galaxy31122004-arch/Do-an-Tuan/documents/sources/esp32-c3-supermini/pinout.png

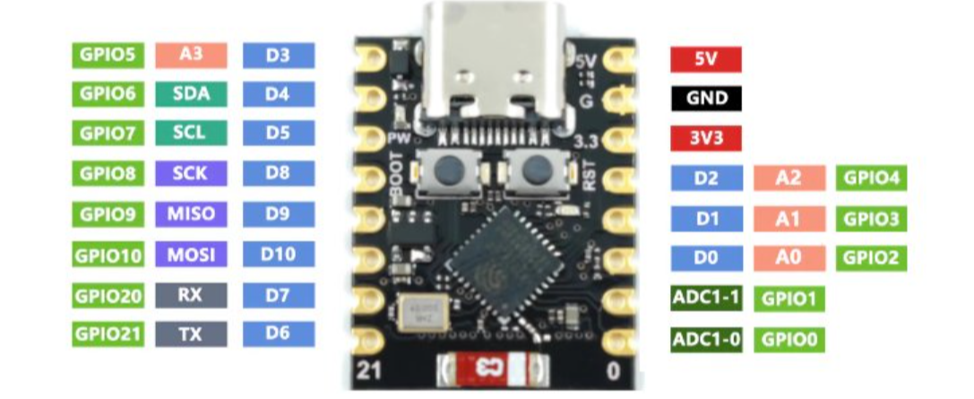
documents/sources/esp32-c3-supermini/pinout.png
