galaxy31122004-arch/Do-an-Tuan/documents/bao-cao-do-an-2/figures/pcb-top.png

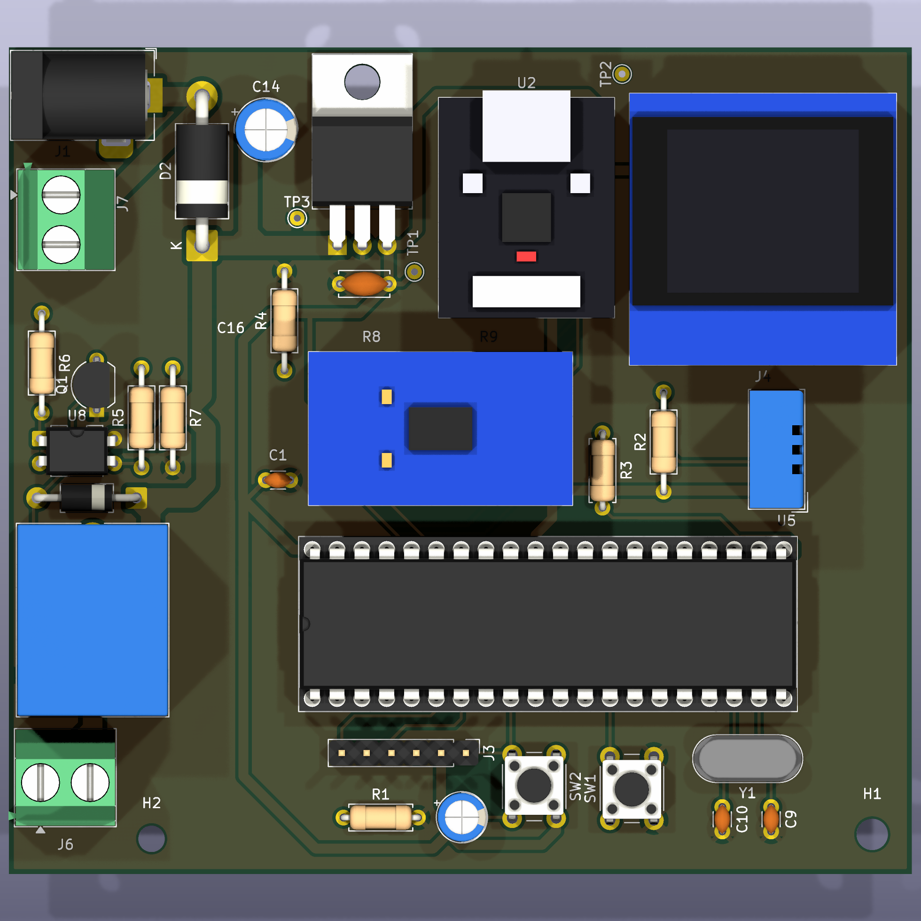
documents/bao-cao-do-an-2/figures/pcb-top.png
