galaxy31122004-arch/Do-an-Tuan/.agents/skills/README.md

# Workspace-local skills

- [workspace-guide](workspace-guide/SKILL.md): workspace conventions and entrypoints for Codex and Claude.

Reusable personal skills belong in a separate collection outside this project (D:\Personal-Skills on the current machine), separate from AXON. Do not copy that collection or plugin caches into the workspace.
