galaxy31122004-arch/Do-an-Tuan/documents/bao-cao-do-an-2/02-yeu-cau-thong-tin.md

# Yêu cầu thông tin và độ sâu — Báo cáo Đồ án 2

Mức viết: `khái quát` · `vừa đủ` · `chuyên sâu` · `tùy chỉnh`. Mức đề xuất ghi trong ngoặc, chờ người dùng chốt.

| Phần | Mức (đề xuất) | Dữ liệu đã có | Còn thiếu | Trạng thái |
|---|---|---|---|---|
| Mở đầu | vừa đủ | Bản tóm tắt đề tài | — | chờ duyệt |
| Chương 1 | vừa đủ | Datasheet công khai, docs/sources.md | Có giới hạn trang cho chương lý thuyết không | chờ duyệt |
| Chương 2 | chuyên sâu | KiCad, BOM, wiring.md, net class | Kích thước header ESP32/TXS chưa đo; giá một số linh kiện chưa khảo sát | đã giao v1.0.0 |
| Chương 3 | chuyên sâu | firmware v0.2.0, dashboard/generate.py | Ảnh dashboard chạy thật (nếu có) | chờ duyệt |
| Chương 4 | vừa đủ | Kế hoạch kiểm thử, kiểm thử phần mềm (checksum HEX, artifact) | **Ảnh mạch thật, số đo nhiệt độ/độ ẩm, kết quả gửi cloud** — chưa có, không tự tạo | chờ dữ liệu |
| Kết luận | khái quát | — | Phụ thuộc chương 4 | chờ |

## Đã chốt (2026-11-08)
- MSSV, địa danh/năm trên bìa: để trống, người dùng tự điền.
- Bìa ghi "BÁO CÁO ĐỒ ÁN 2"; bìa không ảnh (khung, logo, chữ).
- Khoa không quy định thêm; dùng định dạng mặc định trong tệp 01.
- Đồng ý mức viết từng chương như bảng.
- Mạch thật chưa làm/đo: chương 4 viết dạng kế hoạch kiểm thử, kết quả bổ sung sau.
- Không có lời cảm ơn.
- 2026-11-08: cập nhật theo PCB bản cuối (I²C P0.3/P0.4 + R8/R9, UART qua TXS B1/B2, ESP32 RX=GPIO3/TX=GPIO4, bo 92,5 × 84,7 mm đã đi dây, GND phủ hai mặt, bỏ LED D1/R10); hình 2.2, 2.3 và lưu đồ ESP32 dựng lại.
- 2026-11-09: sơ đồ nguyên lý vẽ lại theo 9 khối; PCB đi dây chỉ góc 45°, R1/R3 nằm sát bo; người dùng duyệt, giao `versions/documents/bao-cao-do-an-2/v1.0.0/` (41 trang).
- Dàn ý tệp 01 đã duyệt. Tiến độ: Mở đầu, Chương 1, 2 đã duyệt; Chương 3, 4, Kết luận, TLTK, Phụ lục viết theo yêu cầu "viết hết" và dựng Word `drafts/bao-cao-do-an-2.docx`, chờ duyệt.

## Câu hỏi ưu tiên (đã trả lời)
1. Mã số sinh viên của hai bạn; năm và địa danh ghi trên bìa (ví dụ "Bình Định, 2026"?).
2. Loại tài liệu ghi trên bìa: "BÁO CÁO ĐỒ ÁN 2" hay tên khác theo khoa?
3. Khoa có quy định số trang, cỡ chữ, lề hay cách trích dẫn (IEEE/APA) không?
4. Mức viết từng chương như bảng trên có đồng ý không?
5. Chương 4: mạch thật đã làm/đo chưa? Nếu chưa, viết chương 4 dạng kế hoạch kiểm thử và để kết quả bổ sung sau.
6. Bìa không ảnh (chỉ khung, logo, chữ) có được không?
7. Có cần lời cảm ơn, nhận xét GVHD không?

## Ghi chú
- Không suy diễn kết quả đo hay độ chính xác chưa kiểm chứng.
- Thiết kế đã thay đổi so với bản tóm tắt: thêm relay (PC817 + C1815, bật ≥ 32 °C, tắt ≤ 30 °C), nguồn 12 V qua LM7805, OE = GPIO0, TX ESP32 = GPIO3.
