galaxy31122004-arch/Do-an-Tuan/documents/sources/de-tai/TÓM TẮT ĐỀ TÀI ĐỒ ÁN 2 - IoT OLED.docx

TÓM TẮT ĐỀ TÀI ĐỒ ÁN

THIẾT KẾ HỆ THỐNG GIÁM SÁT NHIỆT ĐỘ, ĐỘ ẨM SỬ DỤNG AT89S52, ESP32-C3 VÀ NỀN TẢNG IoT

Sinh viên thực hiện: Phạm Thanh Tuấn, Nguyễn Quốc Sinh.

Lớp: Kỹ thuật điện tử - viễn thông K46.

Giảng viên hướng dẫn: TS Nguyễn Đỗ Dũng.

1. Lý do chọn đề tài

Nhiệt độ và độ ẩm tương đối là những thông số cần theo dõi trong sinh hoạt, bảo quản sản phẩm và các mô hình giám sát môi trường. Hệ thống chỉ hiển thị tại chỗ giúp người sử dụng quan sát tức thời nhưng chưa hỗ trợ theo dõi từ xa và xem lại diễn biến theo thời gian.

Đề tài hướng đến thiết kế mạch thật vừa đo và hiển thị tại chỗ, vừa truyền dữ liệu qua Internet để lưu trữ, xem biểu đồ và cảnh báo vượt ngưỡng. AT89S52 đảm nhiệm thu thập và hiển thị; ESP32-C3 phụ trách kết nối mạng. Nền tảng IoT có sẵn, theo hướng ThingsBoard, được sử dụng để xây dựng dashboard giám sát trên trình duyệt.

2. Mục tiêu của đề tài

- Tìm hiểu và lập trình AT89S52 để đọc nhiệt độ, độ ẩm từ DHT11; ESP32-C3 đồng bộ giờ NTP, gắn thời gian UTC cho bản ghi và gửi giờ về AT89S52 để hiển thị.

- Thay LCD 2004 bằng OLED trắng 0,96 inch, giao tiếp I²C dùng SSD1315 theo module đã chọn. Xây dựng hai trang thông tin và nút nhấn chuyển trang: trang số đo/ngày giờ; trang trạng thái Wi-Fi, cloud và lần gửi thành công gần nhất.

- Thiết kế giao tiếp UART giữa AT89S52 và ESP32-C3. AT89S52 gửi bản ghi đo; ESP32-C3 phản hồi trạng thái kết nối và gửi dữ liệu để AT89S52 cập nhật màn hình.

- Lập trình ESP32-C3 kết nối Wi-Fi, truyền dữ liệu lên nền tảng IoT và tự kết nối lại khi mất mạng. Lựa chọn, cấu hình nền tảng theo hướng ThingsBoard và các chức năng cần triển khai.

- Thiết lập lưu trữ các bản ghi gồm mã thiết bị, thời gian đo, nhiệt độ và độ ẩm. Cấu hình dashboard web hiển thị dữ liệu mới nhất, biểu đồ lịch sử, lọc theo khoảng thời gian và xuất dữ liệu CSV.

- Cấu hình ngưỡng nhiệt độ, độ ẩm trên nền tảng/web; hiển thị và lưu lịch sử cảnh báo vượt ngưỡng. Phạm vi ban đầu gồm một thiết bị và một tài khoản chủ thiết bị để xem dữ liệu, chỉnh ngưỡng.

- Chế tạo, kiểm tra mạch thật và đánh giá toàn bộ luồng đo, hiển thị, truyền dữ liệu, lưu trữ và giám sát từ xa. Mô phỏng các khối phù hợp trên Proteus để hỗ trợ kiểm tra trước khi tích hợp.

3. Sơ đồ khối

DHT11 → AT89S52
NTP qua Internet → ESP32-C3 → Giờ UTC gửi về AT89S52
AT89S52 → OLED SSD1315 (I²C)
Nút chuyển trang → AT89S52
AT89S52 ↔ ESP32-C3 (UART)
ESP32-C3 → Wi-Fi/Internet → Nền tảng IoT → Dashboard web

Nguồn cấp được phân phối phù hợp cho từng khối. Module TXS0108E chuyển mức I²C và UART giữa phía AT89S52 5 V và OLED/ESP32-C3 3,3 V; chân OE được ESP32-C3 điều khiển sau khi nguồn ổn định. AT89S52 phụ trách đo và hiển thị; ESP32-C3 phụ trách mạng; nền tảng IoT phụ trách lưu trữ, dashboard và xử lý cảnh báo.

4. Nguyên lý hoạt động

Sau khi cấp nguồn, AT89S52 khởi tạo cảm biến và màn hình; ESP32-C3 kết nối mạng và đồng bộ giờ NTP. AT89S52 đọc DHT11, kiểm tra dữ liệu và cập nhật số đo lên OLED. ESP32-C3 gửi giờ UTC cho AT89S52 để hiển thị UTC+7. Khi chưa đồng bộ hoặc mất cập nhật thời gian từ ESP32-C3, OLED báo chưa đồng bộ giờ. Nút nhấn cho phép chuyển giữa trang đo và trang kết nối. Cách điều khiển OLED được lựa chọn phù hợp với bộ nhớ AT89S52 và kiểm tra trên module thực tế.

AT89S52 gửi bản ghi đo sang ESP32-C3 qua UART. ESP32-C3 gắn thời gian UTC lúc nhận bản ghi, bổ sung thông tin nhận diện thiết bị khi cần và chuyển dữ liệu qua Wi-Fi/Internet lên nền tảng ThingsBoard. Trạng thái kết nối và lần gửi thành công được gửi về AT89S52 để hiển thị tại chỗ.

Nền tảng lưu dữ liệu theo thời gian và cung cấp dashboard cho người sử dụng truy cập bằng tài khoản chủ thiết bị. Dashboard hiển thị số đo mới nhất cùng thời gian cập nhật, biểu đồ lịch sử, bộ lọc thời gian và chức năng xuất CSV. Ngưỡng cảnh báo được cấu hình trên nền tảng; khi số đo vượt ngưỡng, hệ thống đánh dấu và lưu sự kiện cảnh báo để tra cứu.

Khi mất Internet, AT89S52 vẫn đo và hiển thị tại chỗ; ESP32-C3 thực hiện kết nối lại và duy trì giờ đã đồng bộ trong khi còn nguồn. Sau mất điện, hệ thống cần NTP để đồng bộ lại; không sử dụng RTC ngoài hoặc pin dự phòng. Dashboard thể hiện thời điểm dữ liệu cuối và trạng thái mất kết nối để phân biệt dữ liệu cũ với số đo hiện tại. Phiên bản đầu không lưu bù dữ liệu trong thời gian mất mạng; lịch sử cần thể hiện khoảng thiếu dữ liệu.

Khi cảm biến lỗi hoặc bản ghi không hợp lệ, hệ thống báo trạng thái lỗi và không coi dữ liệu đó là số đo hợp lệ. Sau khi kết nối được khôi phục, hệ thống tiếp tục gửi các bản ghi mới. Cảnh báo vượt ngưỡng thuộc phạm vi nền tảng/web; đề tài chưa đặt yêu cầu điều khiển tải hoặc bổ sung còi cảnh báo.

5. Mô phỏng và kiểm tra

- Nạp và kiểm tra file HEX AT89S52 bằng mạch nạp Burn-E, sau đó lắp AT89S52 vào mạch. Thiết kế sơ đồ mạch, kiểm tra nguồn và mức tín hiệu giữa các khối; mô phỏng phần đo và hiển thị trên Proteus khi có mô hình phù hợp. Kiểm thử Wi-Fi và cloud bằng mạch thật.

- Kiểm tra đọc DHT11, đồng bộ NTP và truyền giờ về AT89S52, hiển thị hai trang OLED và thao tác nút nhấn. Đối chiếu số đo với thiết bị tham chiếu nếu có, ghi nhận sai lệch quan sát được.

- Kiểm tra trao đổi UART và tính nhất quán của nhiệt độ, độ ẩm, thời gian giữa AT89S52, ESP32-C3 và dữ liệu lưu trên nền tảng.

- Kiểm tra truy cập dashboard qua Internet, dữ liệu mới nhất, biểu đồ, lọc lịch sử, xuất CSV, cấu hình ngưỡng và lưu lịch sử cảnh báo.

- Thử các tình huống cảm biến lỗi, bản ghi lỗi, vượt ngưỡng, mất Wi-Fi/Internet, kết nối lại và khởi động lại thiết bị. Xác nhận việc mất mạng không làm gián đoạn đo và hiển thị tại chỗ.

- Tổng hợp kết quả thực nghiệm, đánh giá tính ổn định, khả năng cập nhật dữ liệu và các giới hạn của mô hình; đề xuất lưu bù dữ liệu và mở rộng nhiều thiết bị cho giai đoạn sau.
