galaxy31122004-arch/Do-an-Tuan/documents/sources/de-tai/README.md

# Tóm tắt đề tài — tư liệu gốc

- Nguồn: người dùng cung cấp; trước đây nằm ở thư mục gốc repo, chuyển vào đây ngày 08/11/2026 khi áp cấu trúc workspace.
- [TÓM TẮT ĐỀ TÀI ĐỒ ÁN 2.docx](TÓM%20TẮT%20ĐỀ%20TÀI%20ĐỒ%20ÁN%202.docx): bản tóm tắt đề tài gốc.
- [TÓM TẮT ĐỀ TÀI ĐỒ ÁN 2 - IoT OLED.docx](TÓM%20TẮT%20ĐỀ%20TÀI%20ĐỒ%20ÁN%202%20-%20IoT%20OLED.docx): bản cập nhật theo hướng IoT + OLED.
- Phạm vi đã xác nhận nằm ở [02-yeu-cau-thong-tin.md](../../de-tai/02-yeu-cau-thong-tin.md); nội dung hai file chưa được đọc lại trong lần chuyển này.
