galaxy31122004-arch/Do-an-Tuan/documents/sources/de-tai/TÓM TẮT ĐỀ TÀI ĐỒ ÁN 2.docx

TÓM TẮT ĐỀ TÀI ĐỒ ÁN

THIẾT KẾ MẠCH CẢM BIẾN ĐỘ ẨM TƯƠNG ĐỐI VÀ NHIỆT ĐỘ SỬ DỤNG PIC16F877A, MÀN HÌNH LCD 2004, RTC DS1307 và DHT11.

Sinh viên thực hiện : Phạm Thanh Tuấn,

Nguyễn Quốc Sinh .

Lớp : Kỹ thuật điện tử - viễn thông k46

Giảng viên hướng dẫn: TS Nguyễn Đỗ Dũng.

1. Lý do chọn đề tài

Trong đời sống hằng ngày cũng như trong sản xuất, nhiệt độ và độ ẩm tương đối là hai thông số môi trường có ảnh hưởng đáng kể đến sức khỏe con người, quá trình bảo quản sản phẩm và hoạt động của nhiều thiết bị. Việc theo dõi chính xác các thông số này giúp con người nắm bắt được tình trạng môi trường và có những biện pháp điều chỉnh phù hợp khi cần thiết.

Cùng với sự phát triển của khoa học kỹ thuật, các hệ thống đo lường và giám sát nhiệt độ, độ ẩm ngày càng được ứng dụng rộng rãi trong gia đình, nông nghiệp, nhà kính, kho bảo quản và các hệ thống tự động hóa. Vì vậy, việc nghiên cứu và thiết kế một mạch có khả năng đo nhiệt độ, độ ẩm và hiển thị các thông số một cách trực quan có ý nghĩa thực tiễn. Đó là lý do em chọn đề tài này .

2. Mục tiêu của đề tài

Tìm hiểu cấu tạo, nguyên lý hoạt động và cách sử dụng vi điều khiển PIC16F877A.

Tìm hiểu cảm biến DHT11 và phương pháp thu thập dữ liệu nhiệt độ, độ ẩm tương đối.

Thiết kế mạch giao tiếp giữa DHT11 và PIC16F877A.

Tìm hiểu và sử dụng RTC DS1307 để đo và duy trì thời gian thực.

Thiết kế giao tiếp giữa PIC16F877A với LCD 2004 để hiển thị các thông số.

Lập trình PIC16F877A để đọc dữ liệu từ DHT11 và DS1307, xử lý dữ liệu và hiển thị lên LCD.

Mô phỏng và kiểm tra hoạt động của hệ thống trên Proteus.

Đánh giá kết quả hoạt động và đề xuất hướng phát triển của hệ thống.

3 . Sơ đồ khối

PIC

DS 1307

Cảm biến

DHT11

LCD

NGUỒN

4 . Nguyên lý hoạt động

Sau khi được cấp nguồn, toàn bộ hệ thống bắt đầu hoạt động. Vi điều khiển PIC16F877A đóng vai trò là bộ điều khiển trung tâm, thực hiện khởi tạo các thiết bị ngoại vi và điều khiển quá trình thu thập, xử lý và hiển thị dữ liệu.

Đầu tiên, PIC16F877A gửi tín hiệu yêu cầu đến cảm biến DHT11 để thực hiện phép đo. DHT11 tiến hành đo nhiệt độ và độ ẩm tương đối của môi trường, sau đó truyền dữ liệu số về PIC16F877A thông qua đường truyền dữ liệu. Vi điều khiển tiếp nhận và xử lý dữ liệu để xác định giá trị nhiệt độ theo đơn vị °C và độ ẩm tương đối theo đơn vị %RH.

Đồng thời, PIC16F877A giao tiếp với mạch thời gian thực DS1307 thông qua chuẩn giao tiếp I²C để đọc các thông tin về giây, phút, giờ, ngày, tháng và năm. DS1307 có nguồn pin dự phòng giúp duy trì thông tin thời gian khi nguồn chính của hệ thống bị ngắt.

Sau khi thu thập dữ liệu từ DHT11 và DS1307, PIC16F877A tiến hành xử lý và gửi các kết quả đến màn hình LCD 2004. LCD hiển thị các thông số nhiệt độ, độ ẩm tương đối và thời gian thực để người sử dụng có thể theo dõi trực tiếp.

Quá trình đo, xử lý và hiển thị được thực hiện lặp lại liên tục theo chương trình đã lập trình trong PIC16F877A. Khi nhiệt độ hoặc độ ẩm môi trường thay đổi, giá trị hiển thị trên LCD cũng được cập nhật tương ứng. Nhờ đó, hệ thống có khả năng giám sát các thông số nhiệt độ, độ ẩm và thời gian thực của môi trường một cách trực quan và liên tục.

5 . Mô phỏng và kiểm tra

Thiết kế mạch trên Proteus

Nạp chương trình cho PIC16F877A

Kiểm tra khả năng đọc dữ liệu DHT11

Kiểm tra thời gian từ DS1307

Kiểm tra khả năng hiển thị trên LCD 2004

Đánh giá kết quả và những hạn chế của mô hình .
