galaxy31122004-arch/Do-an-Tuan/dashboard/local/preview.png

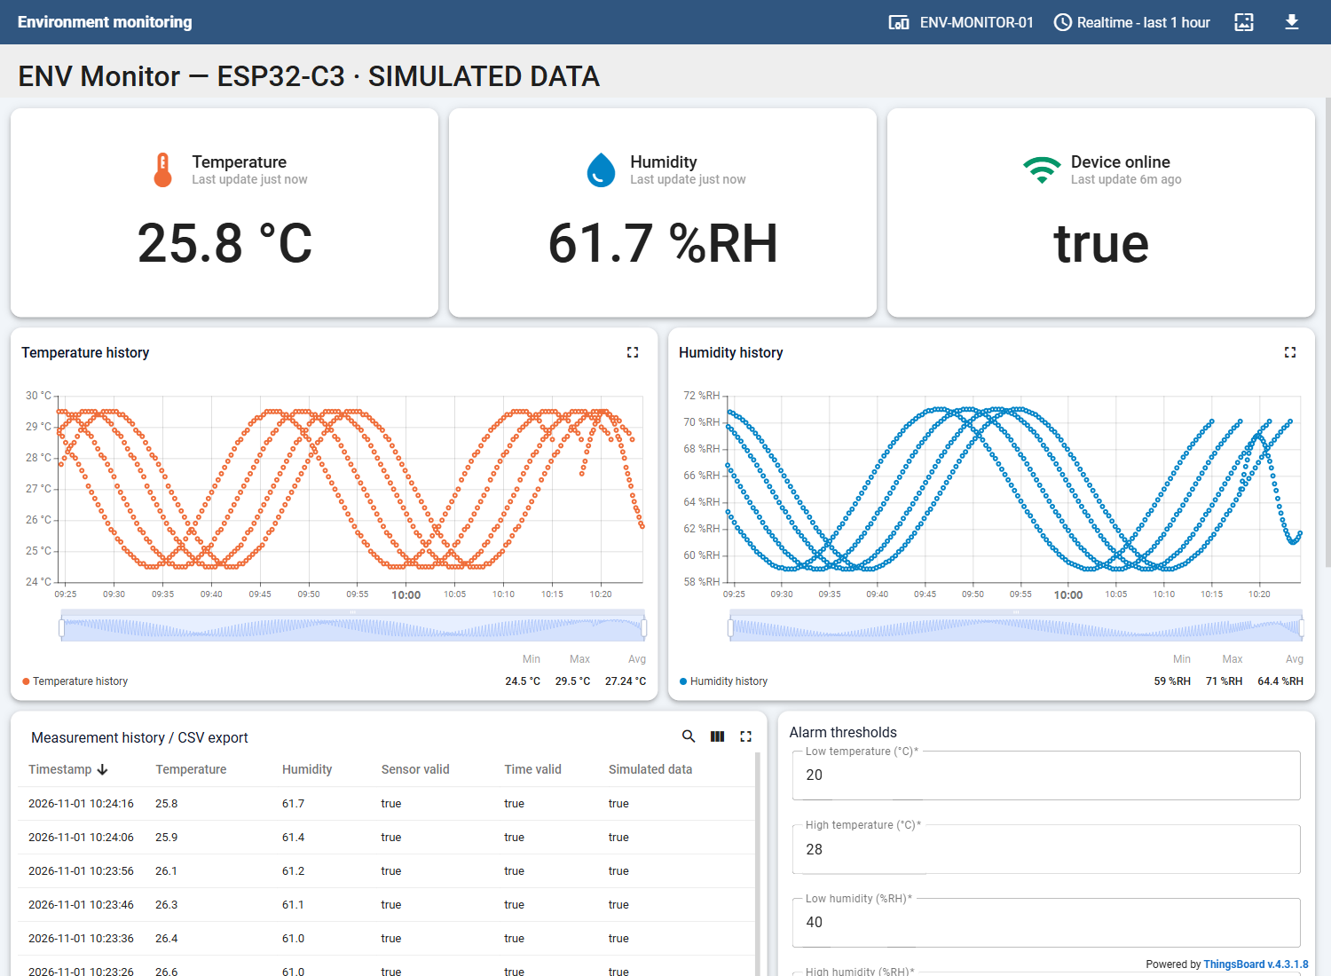
dashboard/local/preview.png
