galaxy31122004-arch/Do-an-Tuan/hardware/BOM.csv

Reference | Quantity | Component | Package | Assembly note | Unit price VND | Fitted subtotal VND | Price source | Price basis / purchasing note
U1 | 1 | AT89S52-24PU | DIP-40 | Bộ xử lý đo/hiển thị; nguồn 5 V | 27000 | 27000 | https://chotroihn.vn/at89s52-24pu-dip40 | 1 IC DIP40; RSCH-20261101-0011; shop khác có giá 79.000đ
U2 | 1 | ESP32-C3 SuperMini | 16 chân, 2 hàng 1x8 | Board ESP32-C3 SuperMini; xác minh footprint và nhãn GPIO trước khi làm PCB | 75000 | 75000 | https://icdayroi.com/kit-phat-trien-wifi-bluetooth-esp32-c3-super-mini-4mb | 1 board; RSCH-20261101-0009
U4 | 1 | Module TXS0108E 8 kênh | Module 2 hàng, đối chiếu footprint | A=3,3 V; B=5 V; bốn kênh I²C/UART; OE từ ESP32 GPIO0 | 15000 | 15000 | https://icdayroi.com/txs0108e-8-kenh-chuyen-muc-logic-1-8v-3-3v-5v | 1 module; RSCH-20261101-0009
U5 | 1 | DHT11 cảm biến rời | 4 chân | VCC/DATA/NC/GND; không nhầm pin module 3 chân | 25000 | 25000 | https://chotroihn.vn/cam-bien-nhiet-do-do-am-dht11 | 1 cảm biến; RSCH-20261101-0009
U6 | 1 | OLED trắng 0,96 inch SSD1315 I²C 128x64 | Module 4 chân | Module Hshop đã chọn; cấp 3,3 V, kiểm tra thứ tự chân in trên module | 65000 | 65000 | https://hshop.vn/lcd-oled-trang-0-96-inch-i2c | 1 màn hình; RSCH-20261101-0009
Y1 | 1 | Thạch anh 11,0592 MHz | HC-49S | Dao động 11,0592 MHz cho UART 9600; đối chiếu điện dung tải | 1500 | 1500 | https://icdayroi.com/thach-anh-11-0592mhz-hc49-dip | 1 thạch anh; RSCH-20261101-0011
R1,R3,R7,R8,R9 | 5 | 10 kΩ 1% 0,25 W | Axial THT | R1 kéo RST chân 9 xuống GND; R3 kéo nút trang lên 5 V; R7 base-emitter Q1 giữ Q1 tắt; R8/R9 kéo SDA/SCL (P0.3/P0.4, cực máng hở) lên 5 V | 120 | 600 | https://chotroihn.vn/tro-vach-1-4w-1-50c | Mua gói 50, dùng 5; trang báo hết hàng biến thể này; cần xác nhận nguồn khác
R6 | 1 | 2,2 kΩ 0,25 W | Axial THT | Hạn dòng LED PC817 (~1,5 mA khi P2.0 kéo xuống) |  |  |  | Chưa khảo sát giá
U8 | 1 | PC817 opto | DIP-4 | LED phía 5 V: +5 V-R6-anode, cathode-P2.0; transistor phía 12 V: C lên +12V, E qua R5 vào base Q1 |  |  |  | Chưa khảo sát giá
R2 | 1 | 4,7 kΩ 1% 0,25 W | Axial THT | Kéo DATA DHT11 lên 5 V | 120 | 120 | https://chotroihn.vn/tro-vach-1-4w-1-50c | Mua gói 50, dùng 1
R4 | 1 | 100 kΩ 1% 0,25 W | Axial THT | Kéo OE TXS0108E xuống GND khi ESP32 khởi động; bỏ pull-up OE trên module nếu có | 120 | 120 | https://chotroihn.vn/tro-vach-1-4w-1-50c | Mua gói 50, dùng 1; trang báo hết hàng biến thể này; cần xác nhận nguồn khác
R5 | 1 | 4,7 kΩ 0,25 W | Axial THT | Từ emitter PC817 (phía 12 V) vào base Q1 |  |  |  | Chưa khảo sát giá; có thể lấy từ gói 4
C1,C16 | 2 | 100 nF X7R ≥16 V | THT 2,54 mm | VCC AT89S52 và đầu ra LM7805; đặt sát chân | 500 | 1000 | https://chotroihn.vn/tu-gom-vang-50v | Giá biến thể 0.1uF/104; đối chiếu điện môi X7R theo BOM trước khi mua
C14 | 1 | 100 µF ≥25 V | Tụ hóa radial | Đầu vào LM7805 sau D2; đúng cực |  |  |  | Chưa khảo sát giá
C9,C10 | 2 | 22 pF C0G/NP0 ≥25 V | Tụ gốm THT | Hai tụ Y1; giá trị khởi đầu, đối chiếu CL thạch anh trước khi chốt PCB | 500 | 1000 | https://chotroihn.vn/tu-gom-vang-50v | Giá biến thể 22P; xác nhận C0G/NP0 và tải thạch anh trước khi mua
C2 | 1 | 10 µF ≥10 V | Tụ hóa radial | C2 reset: cực + lên 5 V, cực - vào RST chân 9 | 1000 | 1000 | https://chotroihn.vn/tu-hoa-16v | C2 reset; kiểm tra cực tính
U7 | 1 | LM7805 ổn áp 5 V 1,5 A | TO-220 nằm ngang, vít xuống PCB | Tab = GND: vít M3 xuống vùng đồng GND hai mặt; với 12 V tỏa ~1,6 W, cần vùng đồng lớn hoặc tản phụ |  |  |  | Chưa khảo sát giá
D2 | 1 | SR360 Schottky 3 A 60 V | DO-201AD | Chống cắm ngược cực nguồn 12 V, sụt áp ~0,5 V; nối tiếp trước LM7805 |  |  |  | Chưa khảo sát giá
SW1,SW2 | 2 | Nút nhấn thường hở | Tactile 6x6 mm | SW1 đổi trang; SW2 reset AT89S52 | 500 | 1000 | https://chotroihn.vn/bo-10-nut-nhan-4-chan | Mua gói 10, dùng 2
J1 | 1 | Jack DC 5,5x2,1 mm hàn mạch | DC-005, 3 chân | Tâm dương; chân switch để trống |  |  |  | Chưa khảo sát giá
J7 | 1 | Domino 2 chân 5,08 mm | Pitch 5,08 mm | Đầu vào 12 V song song jack J1: chân 1 (+), chân 2 GND; chỉ cấp một nguồn |  |  |  | Chưa khảo sát giá
J2A,J2B | 2 | Header cái 1x8 | Pitch 2,54 mm | Đế cắm ESP32; hai hàng cách 15,24 mm (0,6″) theo thông số board | 400 | 800 | https://chotroihn.vn/jump-cai-don-1-40p-2-54 | 2 thanh 40 chân để cắt 8+8+4+10+10; chừa hao hụt khi cắt
J4 | 1 | Header cái 1x4 | Pitch 2,54 mm | Đế cắm OLED | 200 | 200 | https://chotroihn.vn/jump-cai-don-1-40p-2-54 | 2 thanh 40 chân để cắt 8+8+4+10+10; chừa hao hụt khi cắt
J3 | 1 | Header ISP AT89S52 1x6 | Pitch 2,54 mm | RST/VCC/GND/MISO/SCK/MOSI; nạp chính bằng Burn-E ngoài mạch | 300 | 300 | https://chotroihn.vn/jump-duc-don-1x40p-2-54 | 1 thanh 40 chân, dùng 6 chân ISP AT89S52; giả định chân đực module đi kèm module
J5A,J5B | 2 | Header cái 1x10 cho module TXS0108E | Pitch 2,54 mm, xác minh hàng mua | Hàn đế module; chỉnh số chân/footprint nếu module thực tế khác | 500 | 1000 | https://chotroihn.vn/jump-cai-don-1-40p-2-54 | 2 thanh 40 chân để cắt 8+8+4+10+10; chừa hao hụt khi cắt
J6 | 1 | Domino 2 chân 5,08 mm | Pitch 5,08 mm | COM/NO của relay K1 (NC bỏ trống); tải có điện khi relay bật (≥32 °C); chỉ tải điện áp thấp |  |  |  | Chưa khảo sát giá
K1 | 1 | Relay SRD-12VDC-SL-C | Hàn PCB, SPDT | Cuộn 12 V ~30 mA lấy từ +12V sau SR360; chân 2/5 cuộn, 1 COM, 3 NO ra J6, 4 NC bỏ trống |  |  |  | Chưa khảo sát giá
Q1 | 1 | 2SC1815-GR NPN | TO-92 E-C-B | Đóng phía GND cuộn relay, base từ emitter PC817 qua R5 |  |  |  | Chưa khảo sát giá
D3 | 1 | 1N4007 | DO-41 | Điốt dập xung ngược song song cuộn relay |  |  |  | Chưa khảo sát giá
SK1 | 1 | Đế IC DIP-40 | Wide 15,24 mm | Đế AT89S52, hàn đế rồi cắm IC | 1500 | 1500 | https://chotroihn.vn/de-ic | Biến thể 40 chân; xác nhận loại rộng cho AT89S52 DIP40
TP1,TP2,TP3 | 3 | Test point vòng dây | THT | Đo 5 V / 3,3 V / GND | 0 | 0 |  | Tận dụng chân/dây cắt thừa của header đã tính; không mua thêm
