galaxy31122004-arch/Do-an-Tuan/hardware/cost-estimate.csv

Reference | Item | Purchase units/packs | Price per purchase unit VND | Subtotal VND | Source | Note
U1 | AT89S52 DIP-40 | 1 | 27000 | 27000 | https://chotroihn.vn/at89s52-24pu-dip40 | 1 IC DIP40; RSCH-20261101-0011; shop khác có giá 79.000đ
U2 | ESP32-C3 SuperMini 4MB | 1 | 75000 | 75000 | https://icdayroi.com/kit-phat-trien-wifi-bluetooth-esp32-c3-super-mini-4mb | 1 board; RSCH-20261101-0009
U4 | Module TXS0108E | 1 | 15000 | 15000 | https://icdayroi.com/txs0108e-8-kenh-chuyen-muc-logic-1-8v-3-3v-5v | 1 module; RSCH-20261101-0009
U5 | DHT11 rời 4 chân | 1 | 25000 | 25000 | https://chotroihn.vn/cam-bien-nhiet-do-do-am-dht11 | 1 cảm biến; RSCH-20261101-0009
U6 | OLED SSD1315 0,96 inch | 1 | 65000 | 65000 | https://hshop.vn/lcd-oled-trang-0-96-inch-i2c | 1 màn hình; RSCH-20261101-0009
Y1 | Thạch anh 11.0592MHz HC49 DIP | 1 | 1500 | 1500 | https://icdayroi.com/thach-anh-11-0592mhz-hc49-dip | 1 thạch anh; RSCH-20261101-0011
R1,R3,R7,R8,R9 | Điện trở 10kΩ 1/4W 1% | 1 | 6000 | 6000 | https://chotroihn.vn/tro-vach-1-4w-1-50c | Mua gói 50, dùng 5; trang báo hết hàng biến thể này; cần xác nhận nguồn khác
R2 | Điện trở 4,7kΩ 1/4W 1% | 1 | 6000 | 6000 | https://chotroihn.vn/tro-vach-1-4w-1-50c | Mua gói 50, dùng 1
R4 | Điện trở 100kΩ 1/4W 1% | 1 | 6000 | 6000 | https://chotroihn.vn/tro-vach-1-4w-1-50c | Mua gói 50, dùng 1; trang báo hết hàng biến thể này; cần xác nhận nguồn khác
R5 | Điện trở 4.7kΩ 1/4W | 1 |  |  |  | Chưa khảo sát giá; có thể lấy từ gói 4 | 7kΩ của R2
C1,C16 | Tụ gốm 100nF | 2 | 500 | 1000 | https://chotroihn.vn/tu-gom-vang-50v | Giá biến thể 0.1uF/104; đối chiếu điện môi X7R theo BOM trước khi mua
C2 | Tụ hóa 10uF 16V | 1 | 1000 | 1000 | https://chotroihn.vn/tu-hoa-16v | C2 reset; kiểm tra cực tính
C9,C10 | Tụ gốm 22pF | 2 | 500 | 1000 | https://chotroihn.vn/tu-gom-vang-50v | Giá biến thể 22P; xác nhận C0G/NP0 và tải thạch anh trước khi mua
U7 | LM7805 TO-220 | 1 |  |  |  | Chưa khảo sát giá
D2 | Diode Schottky SR360 DO-201AD | 1 |  |  |  | Chưa khảo sát giá
D3 | Diode 1N4007 | 1 |  |  |  | Chưa khảo sát giá
Q1 | Transistor 2SC1815-GR TO-92 | 1 |  |  |  | Chưa khảo sát giá
R6 | Điện trở 2.2kΩ 1/4W | 1 |  |  |  | Chưa khảo sát giá
U8 | Opto PC817 DIP-4 | 1 |  |  |  | Chưa khảo sát giá
C14 | Tụ hóa 100uF 25V | 1 |  |  |  | Chưa khảo sát giá
SW1,SW2 | Nút nhấn 6x6 | 1 | 5000 | 5000 | https://chotroihn.vn/bo-10-nut-nhan-4-chan | Mua gói 10, dùng 2
J1 | Jack DC 5.5x2.1 hàn mạch | 1 |  |  |  | Chưa khảo sát giá
J7 | Domino 2 chân 5.08mm | 1 |  |  |  | Chưa khảo sát giá
J2A,J2B,J4,J5A,J5B | Header cái 2,54mm | 2 | 2000 | 4000 | https://chotroihn.vn/jump-cai-don-1-40p-2-54 | 2 thanh 40 chân để cắt 8+8+4+10+10; chừa hao hụt khi cắt
J3 | Header đực 2,54mm | 1 | 2000 | 2000 | https://chotroihn.vn/jump-duc-don-1x40p-2-54 | 1 thanh 40 chân, dùng 6 chân ISP AT89S52; giả định chân đực module đi kèm module
K1 | Relay SRD-12VDC-SL-C | 1 |  |  |  | Chưa khảo sát giá
J6 | Domino 2 chân 5.08mm | 1 |  |  |  | Chưa khảo sát giá
SK1 | Đế IC 40 chân | 1 | 1500 | 1500 | https://chotroihn.vn/de-ic | Biến thể 40 chân; xác nhận loại rộng cho AT89S52 DIP40
TP1,TP2,TP3 | Test point tự làm | 0 | 0 | 0 |  | Tận dụng chân/dây cắt thừa của header đã tính; không mua thêm
PCB | In PCB theo giá người dùng | 1 | 120000 | 120000 | User supplied | Giá người dùng cung cấp, không phải giá nhà sản xuất đã khảo sát
