galaxy31122004-arch/Do-an-Tuan/hardware/wiring.md

# Sơ đồ nối dây — bản lắp mạch thật

Đối chiếu với `firmware/v0.2.0/at89s52/board.h` và `firmware/v0.2.0/esp32/include/settings.h`. Số chân AT89S52 áp dụng **DIP-40**; board mạng là **ESP32-C3 SuperMini, hai hàng chân 1x8**, tra theo nhãn GPIO trên hàng mua. Sơ đồ nguyên lý và PCB nằm trong `hardware/pcb/` (ERC 0 lỗi, DRC 0 lỗi điện; xem mục 8). Mạch thật chưa lắp, các mục kiểm tra ở mục 7 chưa chạy.

## 1. Nguồn và khối AT89S52

| Kết nối | Đi đến |
|---|---|
| J1 jack DC tâm (+) và J7 domino chân 1 (song song) → D2 SR360 anode | Cathode D2 = VIN: C14 100 µF xuống GND, vào LM7805 IN |
| U7 LM7805 OUT | Rail +5 V; C16 100 nF sát chân OUT |
| U7 LM7805 GND / tab | GND; tab vít M3 xuống vùng đồng GND làm tản nhiệt |
| J1 vỏ (−), J7 chân 2 | GND chung toàn mạch; chân switch của jack để trống |
| AT89S52 VCC chân 40 | +5 V; C1 100 nF đặt cạnh chân 40 (khoảng 7 mm), chân GND của C1 về vùng đồng GND |
| AT89S52 GND chân 20 | GND |
| AT89S52 XTAL1 chân 19 ↔ Y1 11,0592 MHz ↔ XTAL2 chân 18 | C9/C10 22 pF từ từng đầu thạch anh xuống GND |
| AT89S52 RST chân 9 | R1 10 kΩ xuống GND; SW2 từ RST lên +5 V; C2 10 µF cực + lên +5 V, cực - vào RST |
| AT89S52 P3.3 chân 13 | SW1 xuống GND; R3 10 kΩ lên +5 V |
| ESP32 chân 5V/VIN theo board | +5 V, không phải chân 3V3 |
| ESP32 3V3 | Rail 3,3 V cấp OLED và TXS0108E VCCA |
| TXS0108E VCCB / VCCA | +5 V / 3,3 V (tụ lọc có sẵn trên module) |
| TXS0108E OE | ESP32 GPIO0; R4 100 kΩ từ OE xuống GND |
| TP1 / TP2 / TP3 | +5 V / 3,3 V / GND |

**Nguồn LM7805 từ 12 V:** cấp 12 V qua jack J1 **hoặc** domino J7, không cấp cả hai cùng lúc. Dòng tải 5 V ước tính khoảng 180 mA (ESP32 Wi-Fi, AT89S52, OLED; relay đã chuyển sang +12V), đỉnh khoảng 450 mA khi ESP32 phát. LM7805 tỏa khoảng (12 − 0,5 − 5) × 0,18 ≈ **1,2 W**, đỉnh gần 2,5 W khi ESP32 phát. Chỉ tản qua PCB thì cần vùng đồng GND dưới tab rộng khoảng 40×40 mm ở cả hai mặt, nối nhiều via, bôi keo tản nhiệt, và để thoáng; nếu tab vẫn quá nóng khi chạm (trên ~80 °C), gắn thêm tản nhôm nhỏ hoặc hạ adapter xuống 9 V. Tab của 7805 là GND nên vít thẳng xuống đồng GND không cần đệm cách điện. Không cắm USB vào ESP32 khi đang cấp nguồn 12 V.

EA/VPP chân 31 nối thẳng +5 V để chạy Flash trong; PSEN chân 29 và ALE chân 30 để hở. P0 là cực máng hở: P0.3/P0.4 (chân 36/35) dùng cho I²C nên có R8/R9 kéo lên; các chân P0 khác để hở. Các chân I/O còn lại không dùng để NC; không nối ngẫu nhiên vào nguồn. Nút 4 chân tactile có hai cặp nối sẵn: chọn hai chân khác tiếp điểm, đo thông mạch trước khi hàn.

## 2. DHT11 rời

Nhìn chính diện lưới cảm biến và chân hướng xuống, xác minh lại nhãn/datasheet hàng mua.

| DHT11 | Kết nối |
|---|---|
| 1 VCC | +5 V |
| 2 DATA | AT89S52 P3.2 chân 12; R2 4,7 kΩ kéo DATA lên +5 V |
| 3 NC | Để hở |
| 4 GND | GND |

Không áp dụng thứ tự này cho module 3 chân. Đặt cảm biến xa nguồn nhiệt ESP32 và bộ nguồn.

## 3. Nguồn thời gian NTP từ ESP32

Không lắp module thời gian thực hoặc pin dự phòng. ESP32 lấy UTC từ NTP, duy trì giờ khi còn nguồn và gửi frame T cho AT89S52 khoảng mỗi giây. AT89S52 hiển thị UTC+7; chưa có giờ hoặc UART quá hạn sẽ báo TIME NOT SYNCED. Sau mất điện cần đồng bộ lại qua Internet.

## 4. OLED và module TXS0108E

| Kênh | Phía A: 3,3 V | Phía B: 5 V |
|---|---|---|
| A8/B8 — SDA | OLED SDA | AT89S52 P0.3/36 (R8 10 kΩ lên 5 V) |
| A7/B7 — SCL | OLED SCL | AT89S52 P0.4/35 (R9 10 kΩ lên 5 V) |
| A1/B1 — AT89S52 phát | ESP32 GPIO3/RX1 | AT89S52 P3.1/TX/11 |
| A2/B2 — ESP32 phát | ESP32 GPIO4/TX1 | AT89S52 P3.0/RX/10 |
| A3–A6/B3–B6 | NC | NC |
| OLED VCC/GND | 3,3 V/GND (tụ có sẵn trên module) | — |

Kênh chọn theo vị trí trên PCB: B1/B2 nằm ngay trên P3.1/P3.0 (chân 11/10), A1/A2 đi lên GPIO3/GPIO4 không bắt chéo; A7/A8 gần J4, B7/B8 nằm gần P0.4/P0.3 (chân 35/36).

Đấu module theo nhãn A/B và VCCA/VCCB/OE/GND, không dùng số chân IC trần để suy ra header. J5A/J5B là hai hàng 1x10 cách nhau 12,7 mm (0,5″) theo footprint `TXS0108E_Module`, khớp thông số module phổ thông (RSCH-20261109-0001). OLED mặc định `0x3C`; đổi `OLED_ADDR` nếu màn dùng `0x3D`.

OE=GPIO0, R4 100 kΩ kéo xuống GND. ESP32 giữ thấp lúc boot, chờ 100 ms rồi bật mức 3,3 V. Kiểm tra/tháo pull-up hoặc cầu nối kéo cứng OE lên nguồn nếu module có; không đưa 5 V vào GPIO0/OE. AT89S52 thử khởi tạo OLED lại khi TXS chưa bật lúc boot.

Pull-up I²C: phía 5 V bắt buộc có R8/R9 10 kΩ lên +5 V vì P0 của AT89S52 là cực máng hở, không có pull-up nội. Phía 3,3 V dùng pull-up nội của TXS0108E và pull-up có sẵn trên module OLED. R8/R9 nằm ngang dưới module TXS0108E: hàn sát mặt bo trước khi cắm module. Xem datasheet TI trong `docs/sources.md`.

## 5. UART hai chiều, 9600 baud 8N1

```text
AT89S52 P3.1/TX/11 → TXS B1 ↔ A1 → ESP32 GPIO3/RX1
AT89S52 P3.0/RX/10 ← TXS B2 ↔ A2 ← ESP32 GPIO4/TX1
TXS VCCB=5V, VCCA=3V3, GND chung, OE=GPIO0 + R4 100k xuống GND
```

Không còn bộ chia áp TX hoặc buffer riêng. Không nối AT89S52 TX thẳng vào GPIO3 hoặc thêm bộ chia áp trên đường đã qua TXS. Dùng đúng sơ đồ SuperMini C3: UART1 RX=GPIO3, TX=GPIO4 và OE=GPIO0.

## 6. Burn-E nạp AT89S52; J3 ISP

Quy trình chính: ngắt nguồn, tháo AT89S52 khỏi SK1, đặt vào đế/adapter tương thích của Burn-E đúng hướng dẫn của phiên bản đang dùng, chọn AT89S52, mở file HEX, nạp và verify. Cắm AT89S52 trở lại khi mạch tắt nguồn. Không suy đoán vị trí chân 1 trên đế ZIF.

J3 dùng khi đã chọn đúng AT89S52 và đối chiếu pinout trong Burn-E. Có thể nạp trên mạch khi chỉ cấp một nguồn target; hoặc nạp ở mạch đế có thạch anh và EA kéo lên 5 V. Đế ZIF trần không có dao động ngoài không đủ cho ISP AT89S52. Thứ tự J3 theo bảng kết nối AT89S hiển thị trong Burn-E 9.00.88: MCLR/RST, VDD, GND, PGD/MISO, PGC/SCK, AUX/MOSI. Kiểm tra chiều đầu cắm thực tế.

| J3 | AT89S52 |
|---|---|
| 1 RST | Chân 9, reset mức cao |
| 2 VCC | Rail +5 V |
| 3 GND | GND |
| 4 MISO | P1.6 chân 7 |
| 5 SCK | P1.7 chân 8 |
| 6 MOSI | P1.5 chân 6 |

Đánh dấu chân 1. Nếu dùng ISP, chọn nguồn target theo hướng dẫn Burn-E; không cấp đồng thời nguồn mạch nạp và adapter nếu không được thiết kế cho phép. AT89S52 dùng reset mức cao 5 V khi ISP; không dùng cấu hình VPP của PIC.

## 6b. Relay K1 12 V trên board, điều khiển qua PC817 (firmware v0.2.0)

Phía điều khiển (LED của PC817) dùng **+5V** sạch từ LM7805. Phía relay (transistor của PC817, Q1, cuộn K1, D3) lấy **+12V** ngay sau SR360, trước LM7805, nên dòng cuộn relay không đi qua LM7805 và không làm nhiễu rail 5 V. Hai phía **chung GND**, nên đây là tách nguồn chứ không phải cách ly hoàn toàn.

| Phía | Linh kiện | Kết nối |
|---|---|---|
| 5 V | R6 2,2 kΩ | +5V → anode LED PC817 (chân 1) |
| 5 V | U8 PC817 chân 2 | Cathode → AT89S52 P2.0 chân 21 |
| 12 V | U8 PC817 chân 4 / 3 | Collector → +12V; emitter → R5 |
| 12 V | R5 4,7 kΩ, R7 10 kΩ | Emitter PC817 → R5 → base Q1; R7 base → GND |
| 12 V | Q1 2SC1815-GR (E-C-B) | E → GND; C → cuộn K1 chân 2 |
| 12 V | K1 SRD-12VDC-SL-C | Cuộn chân 5 → +12V, chân 2 → Q1; COM chân 1, NO chân 3 ra J6; NC chân 4 bỏ trống |
| 12 V | D3 1N4007 | Cathode +12V (chân 5), anode chân 2 |
| Tải | J6 | 1 COM, 2 NO |

P2.0 **mức thấp** → LED PC817 sáng → Q1 dẫn → relay bật; khi reset P2.0 ở mức cao nên relay không đóng. Dòng LED ≈ 1,5 mA, trong giới hạn kéo xuống của AT89S52. Cuộn 12 V khoảng 30 mA; dòng base qua R5 4,7 kΩ khoảng 1–2 mA (giới hạn bởi CTR của PC817), dư để Q1 bão hòa với C1815 loại **GR**/**Y**.

**Khi vẽ PCB:** cho dòng GND của cuộn relay (emitter Q1) về điểm GND chung gần C14 bằng đường riêng, không đi vòng dưới vùng AT89S52/ESP32.

**Nguồn trong điều khiển, nguồn ngoài đóng cắt:** tiếp điểm chỉ đóng cắt nguồn ngoài của tải và không nối điện với mạch. Đấu: (+) nguồn ngoài → J6 chân 1 (COM); J6 chân 2 (NO) → tải → (−) nguồn ngoài.

Tải nối qua **NO**: relay bật thì tải có điện (ví dụ chạy quạt), relay tắt thì tải bị ngắt. Firmware bật relay khi nhiệt độ ≥ 32,0 °C, tắt khi ≤ 30,0 °C, và tắt khi DHT11 lỗi. Ngưỡng đặt trong `firmware/v0.2.0/at89s52/board.h`. Chỉ đóng cắt tải điện áp thấp; không đưa điện lưới lên PCB.

## 7. Trình tự kiểm tra trước khi cắm IC

1. Kiểm tra chập 5 V/GND và chiều tụ hóa, pin, IC; cấp nguồn giới hạn dòng.
2. Đo 5 V và 3,3 V, kiểm tra nguồn ESP32 ổn định khi Wi-Fi phát.
3. Nạp/verify AT89S52 bằng Burn-E ngoài mạch rồi cắm AT89S52 khi tắt nguồn. Cắm OLED và ESP32, xác nhận OE=3,3 V sau boot rồi kiểm tra thạch anh và ACK I²C.
4. Gắn DHT11, kiểm tra số đo và nút chuyển trang; quan sát TX AT89S52 bằng USB-UART/logic analyzer đúng mức điện áp.
5. Gắn chuyển mức UART và ESP32; xác nhận gói M/S/T, đồng bộ giờ NTP, rồi mới kiểm tra cloud.

## 8. Mạch in (PCB)

Dự án KiCad 10: `hardware/pcb/env-monitor.kicad_pro`; sơ đồ nguyên lý xuất kèm `hardware/pcb/env-monitor-schematic.pdf`.

| Hạng mục | Thông số |
|---|---|
| Kích thước, số lớp | 92,5 × 84,7 mm, 2 lớp, linh kiện xuyên lỗ một mặt (mặt trên) |
| Vùng đồng | GND phủ cả mặt trên (F.Cu) và mặt dưới (B.Cu); không phủ +5V để tránh chập |
| Độ rộng dây | +12V và tiếp điểm relay (J6) 2 mm; +5V/GND 1 mm (một số nhánh +5V 0,5 mm); +3V3 0,5–1 mm; tín hiệu 0,3 mm |
| Khoảng cách tối thiểu | Tín hiệu và +5V/+3V3/GND 0,35 mm; +12V/tải relay 0,5 mm |
| Via | 1 via 0,6/0,3 mm (RELAY, chỗ phải băng qua đường +5V); các dây khác đi trọn trên một mặt. R3 đặt vắt qua đường +5V để BTN_PAGE không cần via |
| Lỗ bắt vít | H1 M3 (góc phải dưới), H2 M2.5 (góc trái dưới); hai góc trên không còn chỗ vì J1 và OLED |
| Footprint đáng chú ý | Mọi điện trở nằm sát bo: R1, R3, R8, R9 bước chân 7,62 mm (R8, R9 dưới module TXS0108E), các điện trở còn lại bước 10,16 mm; C1 tụ đĩa nhỏ bước 2,5 mm; Q1 TO-92 chân rộng |
| Góc đi dây | Đường mạch chỉ đi thẳng hoặc chéo 45°, không có góc cua 90° hay gắt hơn (kiểm bằng `sandbox/kicad/angles.py`) |
| Kiểm tra | ERC 0 lỗi; DRC 0 chân chưa nối, 0 lỗi điện; DRC còn 6 cảnh báo cố ý (R8/R9 nằm trong vùng chiếm chỗ của module TXS0108E); không còn cảnh báo chữ in lụa |

Footprint module đã đối chiếu thông số công bố: ESP32-C3 SuperMini hai hàng cách 15,24 mm (0,6″), bo 22,5 × 18 mm (Protosupplies); module TXS0108E hai hàng cách 12,7 mm (DIP-20, 0,5″), bo 26 × 17 mm (Protosupplies); bước chân 2,54 mm; footprint dùng ±7,62 mm và ±6,35 mm, khớp. Thứ tự chân ESP32 khớp ảnh pinout (`documents/sources/esp32-c3-supermini/`). Trước khi đặt in: xuất Gerber và drill từ KiCad; khi nhận module vẫn nên xem nhãn chân in trên module trùng footprint.

Nguồn: Microchip AT89S52 doc1919 (RSCH-20261101-0011), TI TXS0108E (RSCH-20261101-0005), OLED (RSCH-20261101-0004). Burn-E do người dùng xác nhận; phần mềm đang mở là Burn-E Programmer 9.00.88; xác nhận kết nối phần cứng và pinout hiển thị cho AT89S52 trước khi nạp.
