galaxy31122004-arch/Do-an-Tuan/.agents/skills/workspace-guide/SKILL.md

---
name: workspace-guide
description: Read this workspace guide to locate source files, references, outputs, and verification commands.
---

# Workspace guide

Read the repository-root `AGENTS.md` (../../../AGENTS.md from this directory) before work. It is the canonical source of directory conventions, project rules, linked projects and tools. Read applicable child instructions too.

Use the maintained source for edits; put experiments and unfinished drafts in sandbox, references with adjacent source notes in documents/sources, and delivered snapshots in versions. Read the root README for current entrypoints. Do not copy domain rules into this skill or initialize tools and project state merely by opening the workspace.
