galaxy31122004-arch/Do-an-Tuan/hardware/pcb/env-monitor-schematic.pdf

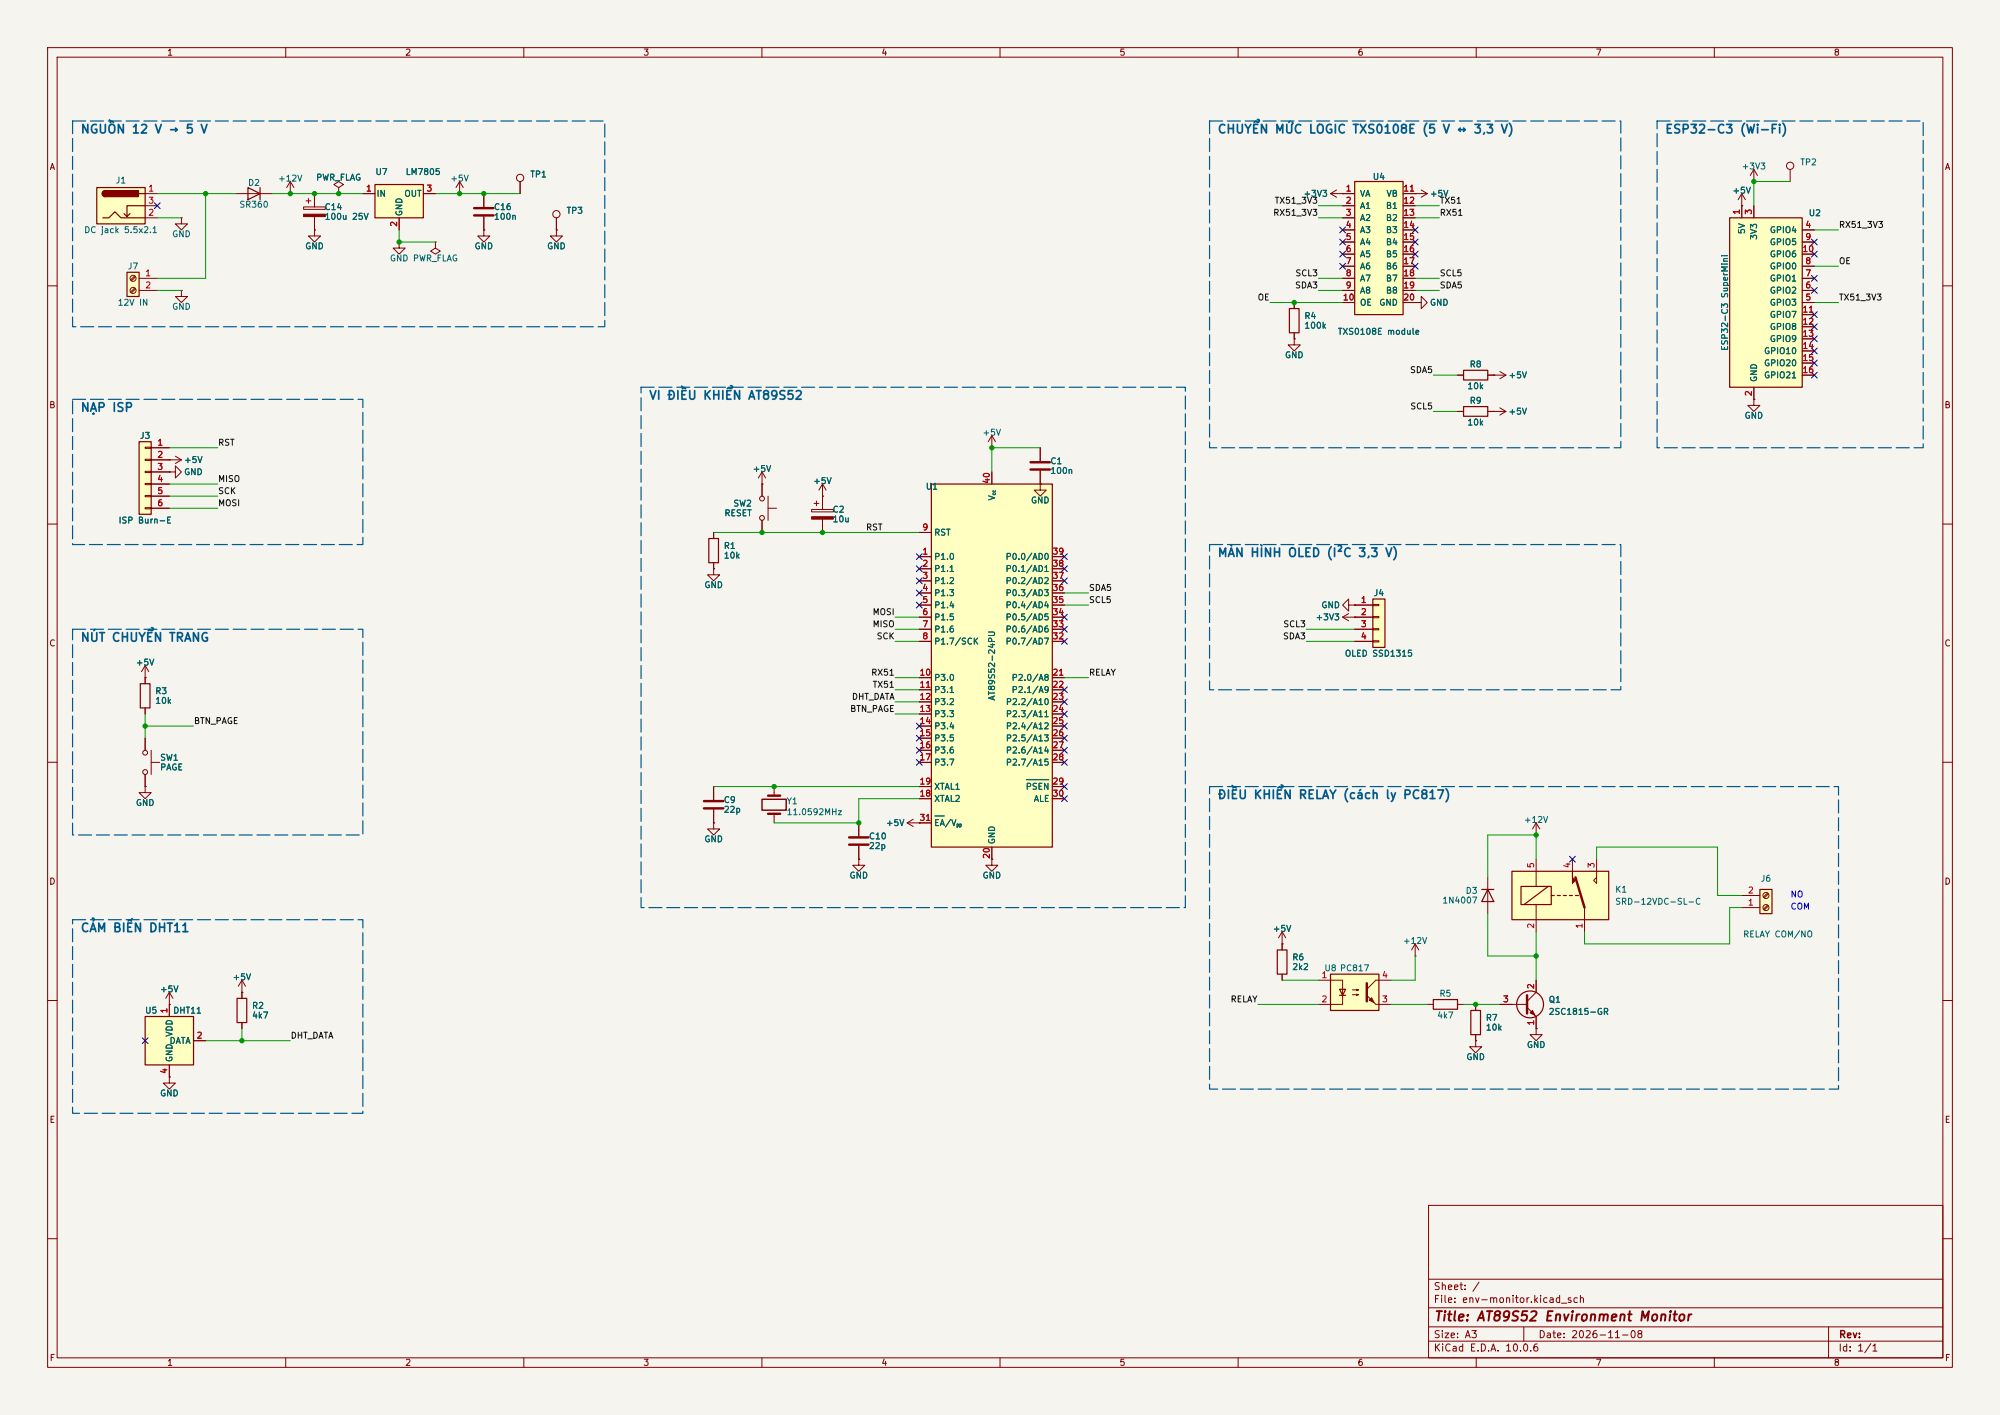
[picture p12: page 1]

MÀN HÌNH OLED (I²C 3,3 V)

ĐIỀU KHIỂN RELAY (cách ly PC817)

Size: A3 | Rev: | F Date: 2026-11-08
KiCad E.D.A. 10.0.6 | Id: 1/1
