galaxy31122004-arch/Do-an-Tuan/hardware/pcb/env-monitor.kicad_pcb

## KiCad design hardware/pcb/env-monitor.kicad_pcb (2026-11-09)

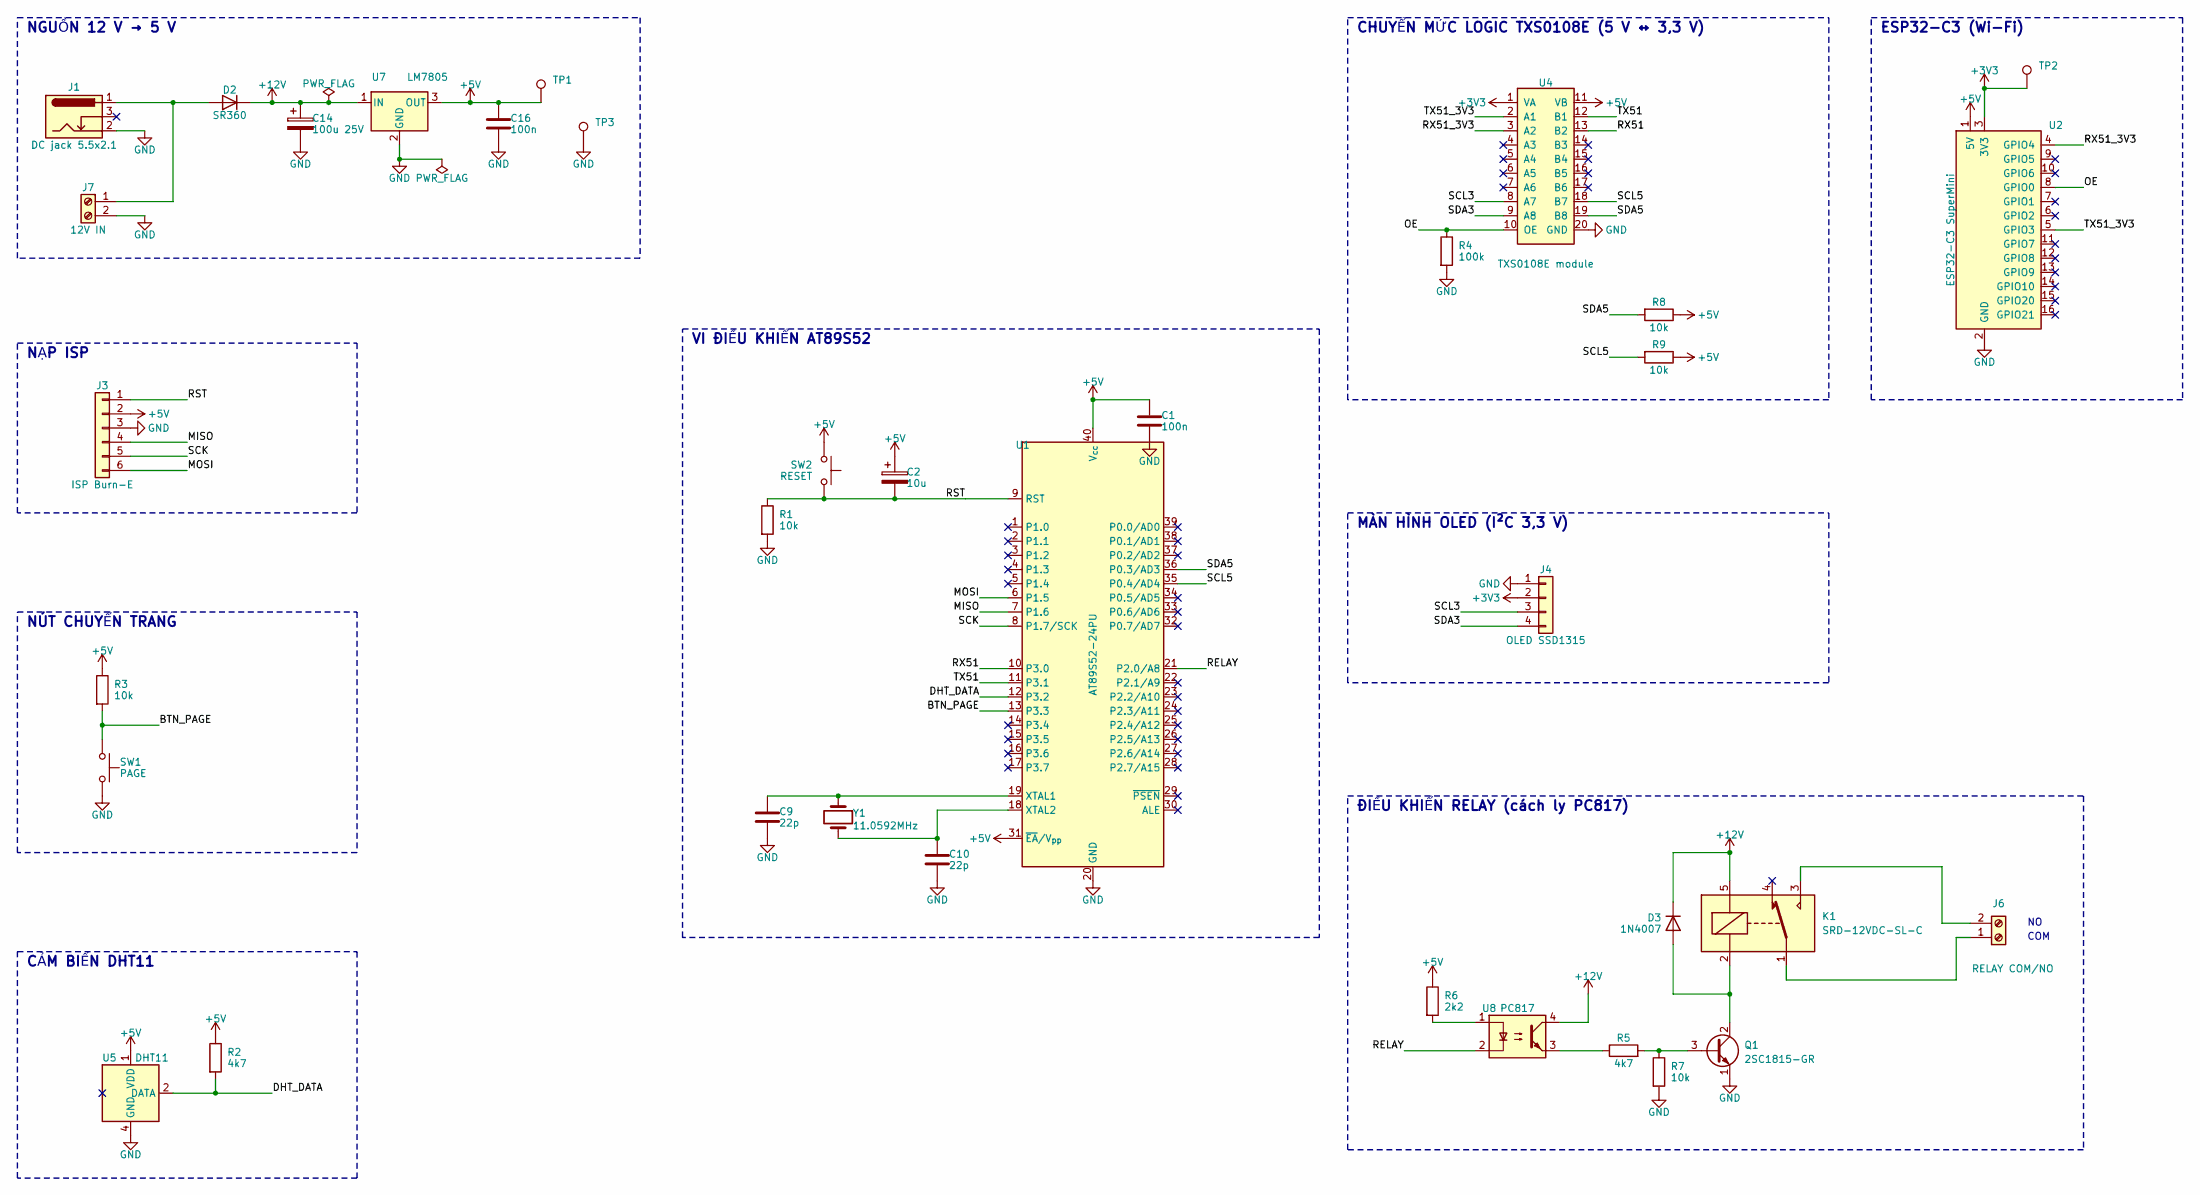
[picture p13: schematic env-monitor.kicad_sch, AT89S52 Environment Monitor]

Parts:
C1: 100n; C_Disc_D3.0mm_W1.6mm_P2.50mm
C2: 10u; CP_Radial_D5.0mm_P2.00mm
C9, C10: 22p; C_Disc_D3.0mm_W1.6mm_P2.50mm
C14: 100u 25V; CP_Radial_D6.3mm_P2.50mm
C16: 100n; C_Disc_D5.0mm_W2.5mm_P5.00mm
D2: SR360; D_DO-201AD_P15.24mm_Horizontal
D3: 1N4007; D_DO-41_SOD81_P10.16mm_Horizontal
J1: DC jack 5.5x2.1; BarrelJack_Horizontal
J3: ISP Burn-E; PinHeader_1x06_P2.54mm_Vertical
J4: OLED SSD1315; OLED_0.96_I2C_Module
J6: RELAY COM/NO; TerminalBlock_Phoenix_MKDS-1,5-2-5.08_1x02_P5.08mm_Horizont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
J7: 12V IN; TerminalBlock_Phoenix_MKDS-1,5-2-5.08_1x02_P5.08mm_Horizont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
K1: SRD-12VDC-SL-C; Relay_SPDT_SANYOU_SRD_Series_Form_C
Q1: 2SC1815-GR; TO-92_Inline_Wide
R1, R3, R8, R9: 10k; R_Axial_DIN0207_L6.3mm_D2.5mm_P7.62mm_Horizontal
R2, R5: 4k7; R_Axial_DIN0207_L6.3mm_D2.5mm_P10.16mm_Horizontal
R4: 100k; R_Axial_DIN0207_L6.3mm_D2.5mm_P10.16mm_Horizontal
R6: 2k2; R_Axial_DIN0207_L6.3mm_D2.5mm_P10.16mm_Horizontal
R7: 10k; R_Axial_DIN0207_L6.3mm_D2.5mm_P10.16mm_Horizontal
SW1: PAGE; SW_PUSH_6mm
SW2: RESET; SW_PUSH_6mm
TP1: +5V; TestPoint_THTPad_D1.5mm_Drill0.7mm
TP2: +3V3; TestPoint_THTPad_D1.5mm_Drill0.7mm
TP3: GND; TestPoint_THTPad_D1.5mm_Drill0.7mm
U1: AT89S52-24PU; DIP-40_W15.24mm_Socket
U2: ESP32-C3 SuperMini; ESP32-C3_SuperMini
U4: TXS0108E module; TXS0108E_Module
U5: DHT11; Aosong_DHT11_5.5x12.0_P2.54mm
U7: LM7805; TO-220-3_Horizontal_TabDown
U8: PC817; DIP-4_W7.62mm
Y1: 11.0592MHz; Crystal_HC49-4H_Vertical

Connections:
+3V3: J4.2, TP2.1 (1_1), U2.3 (3V3), U4.1 (VA)
+5V: C1.1, C2.1, C16.1, J3.2, R2.1, R3.1, R6.1, R8.1, R9.1, SW2.1, TP1.1 (1_1), U1.31 (~EA/V_{pp}), U1.40 (V_{cc}), U2.1 (5V), U4.11 (VB), U5.1 (VDD), U7.3 (OUT)
+12V: C14.1, D2.1 (K), D3.1 (K), K1.5, U7.1 (IN), U8.4
/BTN_PAGE: R3.2, SW1.1, U1.13 (P3.3)
/DHT_DATA: R2.2, U1.12 (P3.2), U5.2 (DATA)
/MISO: J3.4, U1.7 (P1.6)
/MOSI: J3.6, U1.6 (P1.5)
/OE: R4.1, U2.8 (GPIO0), U4.10 (OE)
/RELAY: U1.21 (P2.0/A8), U8.2
/RST: C2.2, J3.1, R1.1, SW2.2, U1.9 (RST)
/RX51: U1.10 (P3.0), U4.13 (B2)
/RX51_3V3: U2.4 (GPIO4), U4.3 (A2)
/SCK: J3.5, U1.8 (P1.7/SCK)
/SCL3: J4.3, U4.8 (A7)
/SCL5: R9.2, U1.35 (P0.4/AD4), U4.18 (B7)
/SDA3: J4.4, U4.9 (A8)
/SDA5: R8.2, U1.36 (P0.3/AD3), U4.19 (B8)
/TX51: U1.11 (P3.1), U4.12 (B1)
/TX51_3V3: U2.5 (GPIO3), U4.2 (A1)
GND: C1.2, C9.2, C10.2, C14.2, C16.2, J1.2, J3.3, J4.1, J7.2, Q1.1 (E), R1.2, R4.2, R7.2, SW1.2, TP3.1 (1_1), U1.20 (GND), U2.2 (GND), U4.20 (GND), U5.4 (GND), U7.2 (GND)
unnamed: D2.2 (A), J1.1, J7.1
unnamed: D3.2 (A), K1.2, Q1.2 (C)
unnamed: J6.1, K1.1
unnamed: J6.2, K1.3
unnamed: Q1.3 (B), R5.2, R7.1
unnamed: R5.1, U8.3
unnamed: R6.2, U8.1
unnamed: C9.1, U1.19 (XTAL1), Y1.1
unnamed: C10.1, U1.18 (XTAL2), Y1.2

Notes on the sheet:
NGUỒN 12 V → 5 V
NẠP ISP
NÚT CHUYỂN TRANG
CẢM BIẾN DHT11
VI ĐIỀU KHIỂN AT89S52
CHUYỂN MỨC LOGIC TXS0108E (5 V ↔ 3,3 V)
ESP32-C3 (Wi-Fi)
MÀN HÌNH OLED (I²C 3,3 V)
ĐIỀU KHIỂN RELAY (cách ly PC817)
COM

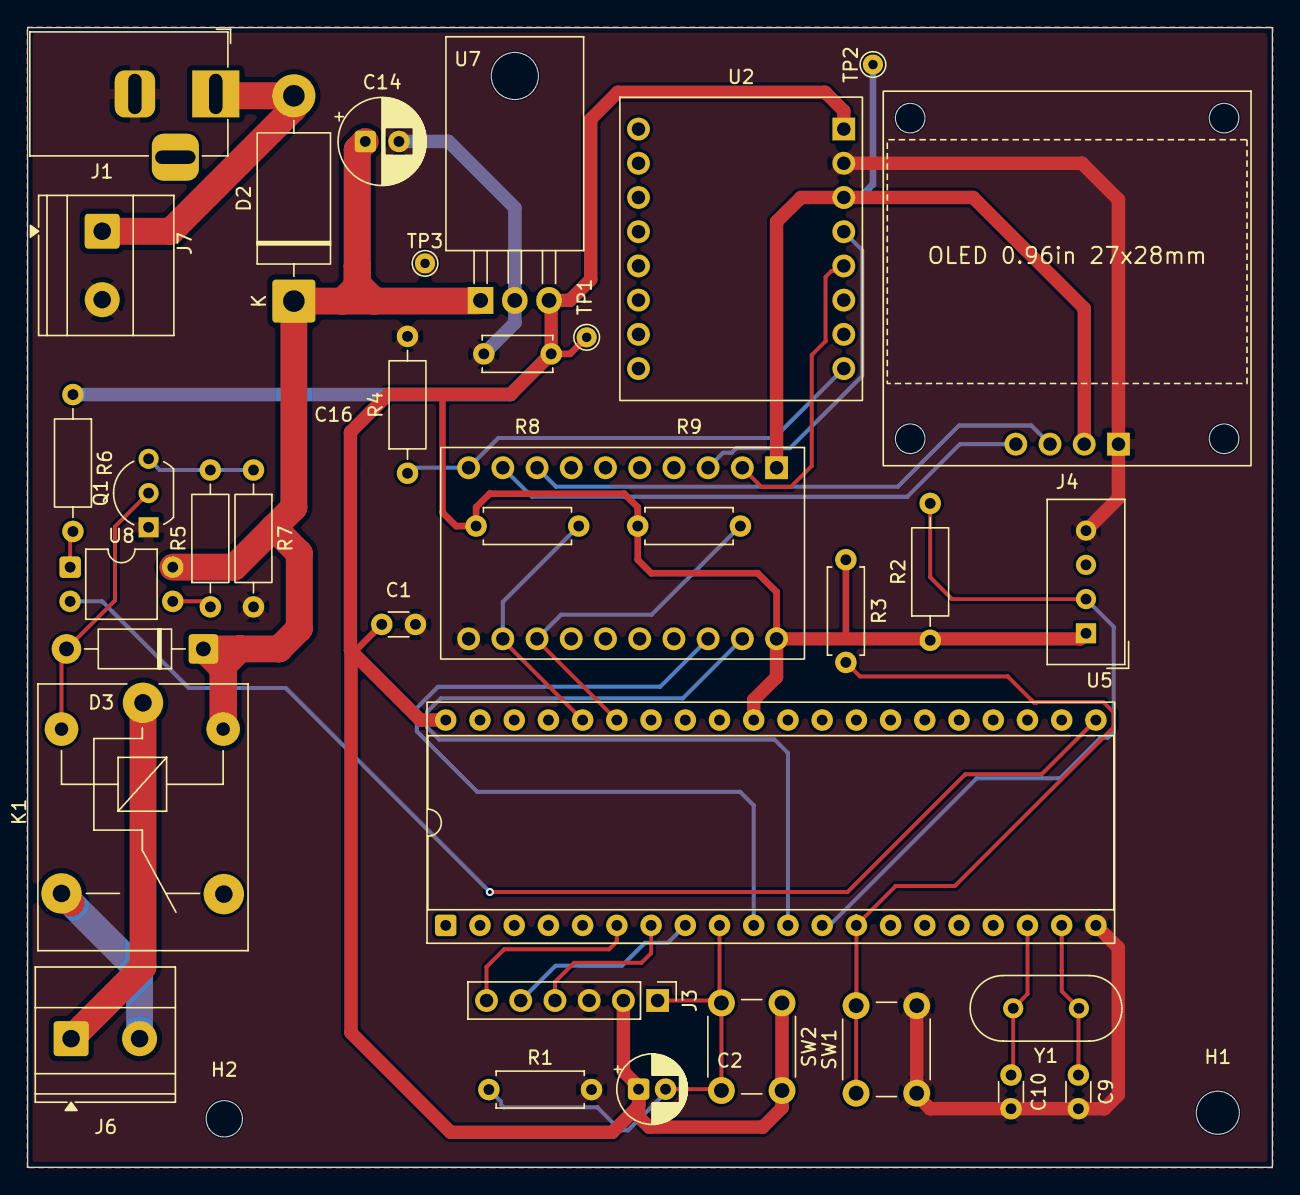
[picture p14: board env-monitor.kicad_pcb from above]

Board: 2 copper layers, 92.4 x 84.6 mm, 38 parts (0 on the bottom side), 29 nets.

Other parts of the board:
H1: M3; MountingHole_3.2mm_M3
H2: M2.5; MountingHole_2.7mm_M2.5
