galaxy31122004-arch/Do-an-Tuan/(commit log)

2026-11-01 feat: add PIC ESP32 firmware dashboard and assembly documentation
    [BOM.csv]
2026-11-01 feat: switch level shifting to TXS0108E and PIC programming to Burn-E
    [BOM.csv]
2026-11-01 feat: use C3 NTP clock and local English ThingsBoard dashboard with BOM costing
    [BOM.csv, cost-estimate.csv]
2026-11-01 docs: add per-item prices and purchasing totals to BOM
    [BOM.csv]
2026-11-01 feat: migrate sensing controller to AT89S52 and update priced BOM
    [BOM.csv, cost-estimate.csv]
2026-11-08 chore: apply structured workspace layout
    - Add AGENTS.md, CLAUDE.md and workspace-guide skill pointers
    - Move firmware into firmware/v0.1.0/ with a version table README
    - Move topic .docx files into documents/sources/de-tai/ with a note
    - Update paths in docs, tests, build script, ignore rules; rebuild HEX (byte-identical)
    - Fix spacing in README price row
    [board.h, build.py, main.c, main.cpp]
2026-11-08 docs: move topic structure and scope notes into documents/de-tai
2026-11-08 feat: add relay output on P2.0 (firmware v0.2.0)
    - Copy firmware to v0.2.0; v0.1.0 stays frozen
    - AT89S52 drives active-low relay module via J6: on >= 32.0 C,
    off <= 30.0 C, off on sensor error; flag bit 2 in M frame; OLED row
    - ESP32 publishes "relay" telemetry; dashboard gets a Relay card
    - BOM adds J6 header and K1 module (price not yet surveyed)
    - wiring.md section 6b; repo paths point to v0.2.0
    - Ignore rules cover every firmware version
    [BOM.csv, cost-estimate.csv]
2026-11-08 feat: add KiCad schematic for env-monitor board
    All nets from wiring.md (incl. relay J6) as global labels; ERC: only intentionally unused pins and off-grid label warnings remain. Module headers use assumed pin orders to verify against bought parts.
    Claude-Session: https://claude.ai/code/session_01JnbMyHEQZCdvYa7ViyoAzk
    [env-monitor.kicad_pcb, env-monitor.kicad_sch]
2026-11-08 feat: wire KiCad schematic with real wires instead of labels
    Signals routed as wires on per-net trunks, rails as power symbols, no-connect flags on unused pins. Netlist matches wiring.md; ERC 0 errors 0 warnings. Generator and netlist check kept in sandbox/kicad.
    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
    [env-monitor.kicad_sch]
2026-11-08 fix: label ESP32-C3 SuperMini headers with real GPIO names
    J2A is the right row (5V/GND/3V3/GPIO4..0), J2B the left row (GPIO5..10/20/21), per pinout image saved in documents/sources. Wiring unchanged; netlist match, ERC 0/0. Ignore KiCad history/lock files.
    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
    [env-monitor.kicad_sch]
2026-11-08 feat: replace 5V terminal and PTC with DC jack, 1N4007 and LM7805
    LM7805 lies flat with its GND tab screwed to a GND copper pour as heatsink. Input caps 100u + 330n, output 100n. PWR_FLAG moved to VIN. Netlist match, ERC 0/0. BOM/wiring updated; new parts not yet priced.
    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
    [BOM.csv, cost-estimate.csv, env-monitor.kicad_sch]
2026-11-08 feat: place decoupling caps beside the parts they serve, wired to supply pins
    C1/C11 at AT89S52 VCC, C6/C7 at ESP32 5V, C3/C13 at TXS VCCB/VCCA, C12 at DHT11, C5/C8 at OLED, C16 at LM7805 OUT. Netlist match, ERC 0/0.
    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
    [env-monitor.kicad_sch]
2026-11-08 feat: single-block ESP32-C3/TXS0108E modules and on-board relay driver
    Project symbol + footprint library (env-monitor) for ESP32-C3 SuperMini (2x8) and TXS0108E module (2x10); row spacings 15.24/12.70 mm still to verify. Relay: P2.0 -> R5 -> S8550 PNP -> SRD-05VDC coil with 1N4007 flyback and R6 pull-up, contacts to 3-pin terminal; firmware active-low unchanged. Netlist match, ERC 0/0, BOM/wiring/tests updated.
    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
    [BOM.csv, cost-estimate.csv, env-monitor.kicad_sch]
2026-11-08 feat: drive relay with 2SC1815 NPN, invert relay logic in firmware v0.2.0
    R6 3k3 pulls the base node up, P2.0 low turns the relay off (~1.5 mA sink); R5 1k series, R7 10k base-emitter, D3 across coil. Firmware: P2.0 high = relay on, P2 starts at 0xFE. Relay pulses on briefly during reset at power-up. Netlist match, ERC 0/0, sim and artifact tests pass.
    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
    [BOM.csv, cost-estimate.csv, env-monitor.kicad_sch]
2026-11-08 feat: relay output uses COM/NC only on a 2-pin terminal
    NO contact left unconnected (no-connect). Load is powered while the relay is off. Netlist match, ERC 0/0; BOM and wiring updated.
    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
    [BOM.csv, cost-estimate.csv, env-monitor.kicad_sch]
2026-11-08 feat: add 12V screw terminal in parallel with DC jack, D2 to SR360
    J7 shares VJACK/GND with J1. D2 SR360 Schottky (DO-201AD). wiring.md power note recalculated for 12 V (~1.6 W in LM7805). Netlist match, ERC 0/0.
    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
    [BOM.csv, cost-estimate.csv, env-monitor.kicad_sch]
2026-11-08 feat: isolate relay driver with PC817, relay back to active-low
    P2.0 sinks the PC817 LED via R6 2k2; opto emitter drives the 2SC1815 base through R5. Relay no longer pulses at power-up. Firmware v0.2.0: P2.0 low = relay on. Netlist match, ERC 0/0, sim and artifact tests pass.
    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
    [BOM.csv, cost-estimate.csv, env-monitor.kicad_pcb, env-monitor.kicad_sch]
2026-11-08 feat: power relay stage from its own isolated supply (J8)
    PC817 collector, coil, D3, Q1 and R7 now sit on RLY_VCC/RLY_GND from J8, separate from +5V/GND; only the PC817 LED stays on the logic side. Netlist match, ERC 0/0; BOM and wiring updated.
    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
    [BOM.csv, cost-estimate.csv, env-monitor.kicad_sch]
2026-11-08 Revert "feat: power relay stage from its own isolated supply (J8)"
    This reverts commit 2ec0e96f8bbcbefc98ae784748ca1d462876f9f3.
    [BOM.csv, cost-estimate.csv, env-monitor.kicad_sch]
2026-11-08 docs: relay coil on board supply, contacts switch the external load supply
    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
2026-11-08 docs: rule to close KiCad before AI updates hardware/pcb files
    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
2026-11-08 feat: run relay side from +12V, SRD-12VDC relay
    VIN after SR360 becomes the +12V power net; PC817 collector, coil and D3 move from +5V to +12V so relay current bypasses the LM7805. R5 4k7. Netlist match, ERC 0/0; BOM and wiring updated (LM7805 load ~180 mA).
    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
    [BOM.csv, cost-estimate.csv, env-monitor.kicad_sch]
2026-11-08 chore: save user's manual KiCad edits (schematic and PCB placement)
    Includes J6 pin 2 moved from K1 NC (pin 4) to NO (pin 3) as edited in KiCad.
    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
    [env-monitor.kicad_pcb, env-monitor.kicad_sch]
2026-11-08 feat: net classes - signals 0.5 mm, +12V/load 2 mm, 5V/3V3/GND 1 mm
    Power_12V: +12V, jack-to-SR360 net, relay load nets (J6), clearance 0.5 mm, via 1.2/0.6. Power: +5V, +3V3, GND 1 mm. Default 0.5 mm, clearance 0.25 mm.
    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
2026-11-08 chore: save user's KiCad edits before OLED footprint change
    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
    [env-monitor.kicad_pcb]
2026-11-08 feat: J4 uses OLED 0.96in module footprint with real board outline
    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
    [env-monitor.kicad_pcb, env-monitor.kicad_sch]
2026-11-08 chore: save user's KiCad edits before board outline
    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
    [env-monitor.kicad_pcb, env-monitor.kicad_sch]
2026-11-08 feat: 100x100 mm board outline on Edge.Cuts
    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
    [env-monitor.kicad_pcb]
2026-11-08 chore: save user's KiCad edits before removing capacitors
    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
    [env-monitor.kicad_pcb]
2026-11-08 feat: drop 9 capacitors (keep C1, C2, C9, C10, C14, C16); modules carry their own decoupling
    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
    [BOM.csv, env-monitor.kicad_pcb, env-monitor.kicad_sch]
2026-11-08 chore: save user's PCB placement before pin swap
    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
    [env-monitor.kicad_pcb]
2026-11-08 feat: swap TXS channels and ESP32 pins to match PCB placement (RX=GPIO4, TX=GPIO3, OE=GPIO0; I2C on A7/A8-B7/B8, UART on A4/A5-B4/B5)
    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
    [BOM.csv, env-monitor.kicad_sch]
2026-11-08 chore: save user's PCB edits
    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
    [env-monitor.kicad_pcb]
2026-11-08 feat: relay load on NO contact (load on at >=32 C); drop removed caps from wiring/BOM; report plan, intro, ch1, ch2 drafts
    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
    [BOM.csv, cost-estimate.csv, env-monitor.kicad_pcb, env-monitor.kicad_sch]
2026-11-08 feat: move AT89S52 I2C to P0.1/P0.2 (pins 38/37) next to TXS B8/B7; add R8/R9 10k pull-ups
    AT89S52 HEX not rebuilt (SDCC missing); check_artifacts checksum fails until rebuild.
    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
    [BOM.csv, cost-estimate.csv, env-monitor.kicad_sch]
2026-11-08 feat: route UART through TXS B1/B2 (above AT89S52 pins 11/10); ESP32 RX=GPIO3, TX=GPIO4
    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
    [env-monitor.kicad_sch]
2026-11-08 chore: user PCB edits (F8 update, placement)
    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
    [env-monitor.kicad_pcb]
2026-11-08 feat: move I2C to P0.3/P0.4 (pins 36/35) per PCB placement
    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
    [BOM.csv, env-monitor.kicad_sch]
2026-11-08 feat(pcb): autoroute remaining nets with Freerouting (existing tracks kept), GND pour on B.Cu, I2C pads to U1.36/35
    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
    [env-monitor.kicad_pcb]
2026-11-08 fix(pcb): DRC cleanup - Q1 TO-92 wide, R1/R3/R8/R9 vertical and moved off U1/U4, TPs on board, OLED fp from lib, net names; reroute
    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
    [env-monitor.kicad_pcb, env-monitor.kicad_sch]
2026-11-08 chore: user PCB edits (removed R3/R8/R9 placement)
    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
    [env-monitor.kicad_pcb]
2026-11-08 fix(pcb): re-place R3/R8/R9, route all nets (+5V pour on F.Cu, GND on B.Cu), TP2 link, silk refs, widen board to fit OLED
    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
    [env-monitor.kicad_pcb]
2026-11-08 feat(pcb): R1/R3/R8/R9 back to horizontal (P7.62), re-placed and rerouted
    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
    [env-monitor.kicad_pcb, env-monitor.kicad_sch]
2026-11-08 feat(pcb): R1/R3/R8/R9 vertical again; R8/R9 pull-ups under the TXS0108E module
    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
    [env-monitor.kicad_pcb, env-monitor.kicad_sch]
2026-11-08 fix(pcb): review fixes - R8/R9 horizontal under TXS module, C1 near AT89S52 pin 40, M3/M2.5 mounting holes; schematic PDF
    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
    [env-monitor.kicad_pcb, env-monitor.kicad_sch]
2026-11-08 fix: regenerate schematic PDF under its existing name
    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
2026-11-08 fix(pcb): GND pour on both layers, no +5V pour; +5V routed with tracks
    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
    [env-monitor.kicad_pcb]
2026-11-08 docs: wiring/BOM match final PCB (pull-ups R8/R9, PCB section, D1/R10 removed, TXS channels)
    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
    [BOM.csv, cost-estimate.csv]
2026-11-08 docs: wiring SVG TXS channel labels
    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
2026-11-08 docs(report): update to final PCB - pins, pull-ups, PCB section, figures; rebuild Word draft
    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
2026-11-08 feat(pcb): 3D models for ESP32-C3, TXS0108E, OLED modules; AT89S52 chip on socket
    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
    [env-monitor.kicad_pcb]
2026-11-08 fix(pcb): J6/J7 terminal blocks face the board edge (were reversed); rerouted
    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
    [env-monitor.kicad_pcb]
2026-11-08 docs(report): 3D PCB figure (Hinh 2.4), updated renders
    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
2026-11-08 docs(slides): pins, pull-ups and final PCB on slides 5, 6, 8
    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
2026-11-08 docs(schematic): redraw as 9 framed blocks; wires inside blocks, net labels between
    Connectivity unchanged (netlist check); new labels RST, MOSI, MISO, SCK,
    DHT_DATA, BTN_PAGE, RELAY renamed in the PCB. ESP32 symbol supply pins moved
    so names clear GPIO labels. ERC 0, DRC parity 0. Report figure and slide 8 updated.
    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
    [env-monitor.kicad_pcb, env-monitor.kicad_sch]
2026-11-09 fix(pcb): 45-degree routing only, R1/R3 laid flat; docs, report, slide updated
    - 12 sharp (90 deg) corners chamfered or tiny stubs merged, 2 off-45 segments
    split; every change DRC-checked (angles.py reports 0 / 0)
    - R1, R3 -> axial P7.62 horizontal; R3 shifted 1.12 mm, +5V/BTN_PAGE rejoined
    - DRC: 0 unconnected, 0 electrical; parity 0; ERC 0
    - wiring.md, report ch.2 (Hinh 2.3/2.4 re-rendered), KiCad slide image
    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
    [env-monitor.kicad_pcb, env-monitor.kicad_sch]
2026-11-09 build(at89s52): rebuild v0.2.0 HEX with I2C on P0.3/P0.4 (SDCC 4.5.0)
    check_artifacts PASS (HEX checksums, 7486 bytes, source hashes);
    test_at89s52_sim PASS (S/T parsing, OLED pages, DHT11 timing).
    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
2026-11-09 docs: review fixes - stale cost sheet, TXS channel table, plan notes, I2C comment
    - cost-estimate.md now generated from cost-estimate.csv by generate.py
    (was PIC-era: R10, D1, F1, 403.500d)
    - level-shifter-options.md: channels A1/B1, A2/B2, A7/B7, A8/B8, OE GPIO0
    - report plan files: PCB size, delivery status
    - main.c comment P1 -> open-drain P0; HEX rebuilt, tests PASS
    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
    [generate.py, main.c]
2026-11-09 fix(pcb): clear silkscreen warnings (OLED display outline, D3 K mark, J6 ref)
    DRC now 6 warnings, all intentional (R8/R9 under the TXS0108E module);
    0 unconnected, 0 electrical, parity 0. Report draft and wiring.md updated.
    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
    [env-monitor.kicad_pcb]
2026-11-09 fix(pcb): 4 vias -> 2; module footprints checked against vendor specs
    - TX51/RX51 stay on B.Cu, RELAY run moved to F.Cu so they no longer cross;
    2 vias left where BTN_PAGE and RELAY must pass under +5V. 45-degree rule kept.
    - DRC 6 (intentional R8/R9), 0 unconnected, parity 0
    - ESP32-C3 SuperMini rows 15.24 mm, TXS0108E module rows 12.7 mm (Protosupplies,
    RSCH-20261109-0001) match the footprints; docs, report draft updated
    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
    [BOM.csv, env-monitor.kicad_pcb]
2026-11-09 fix(pcb): R3 flipped across +5V (no BTN_PAGE via); signals 0.3 mm, clearance 0.35 mm
    - 1 via left (RELAY under +5V); 45-degree rule kept
    - Default/Power clearance 0.25/0.3 -> 0.35 mm; signal tracks 0.5/0.38 -> 0.3 mm; SCK jog by U1 pin 6 rerouted
    - DRC 6 (intentional R8/R9), 0 unconnected, parity 0; ERC 0; docs and report draft updated
    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
    [env-monitor.kicad_pcb]
